MUDAL/Automated-Irrigation-System/Images/MQTT dashboard.jpg

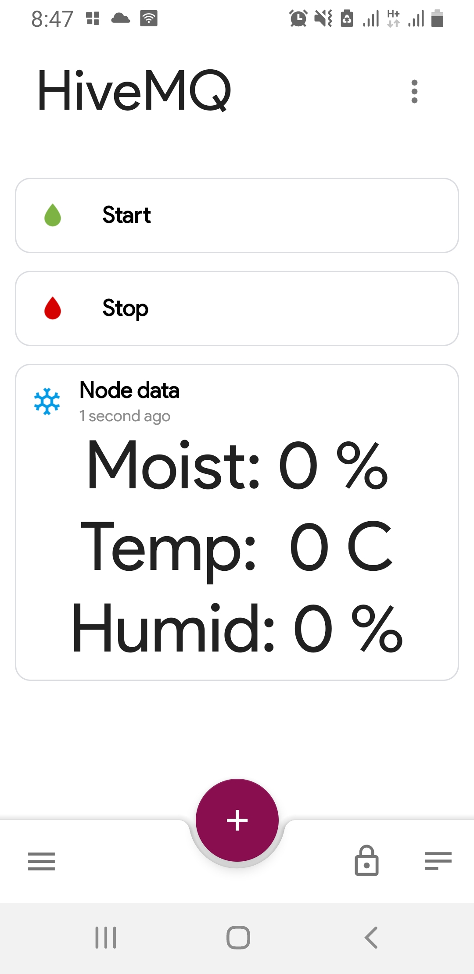
Images/MQTT dashboard.jpg
