MUDAL/Automated-Irrigation-System/Tests/README.md

# Tests

## ``Weather forecast experiment``  

## Credits  
1. https://randomnerdtutorials.com/esp32-http-get-open-weather-map-thingspeak-arduino/  

## HTTP request to get forecast from OpenWeatherMap.org  

Format: https://api.openweathermap.org/data/2.5/weather?q={city},{country_code}&APPID={api_key}  

After opening an account, an API key will be obtained.
To obtain the weather data for Ibadan (a city in Nigeria) with the API key, the following request is made:  

https://api.openweathermap.org/data/2.5/weather?q=Ibadan,NG&APPID={api_key}  
where ``api_key`` is the API key (use yours).    

## ``Other tests``  
1. RTC test  
2. LCD test  
3. Keypad test
