MUDAL/Automated-Irrigation-System/Schematic/Master/Auto_Irrig_Master_PDF.pdf

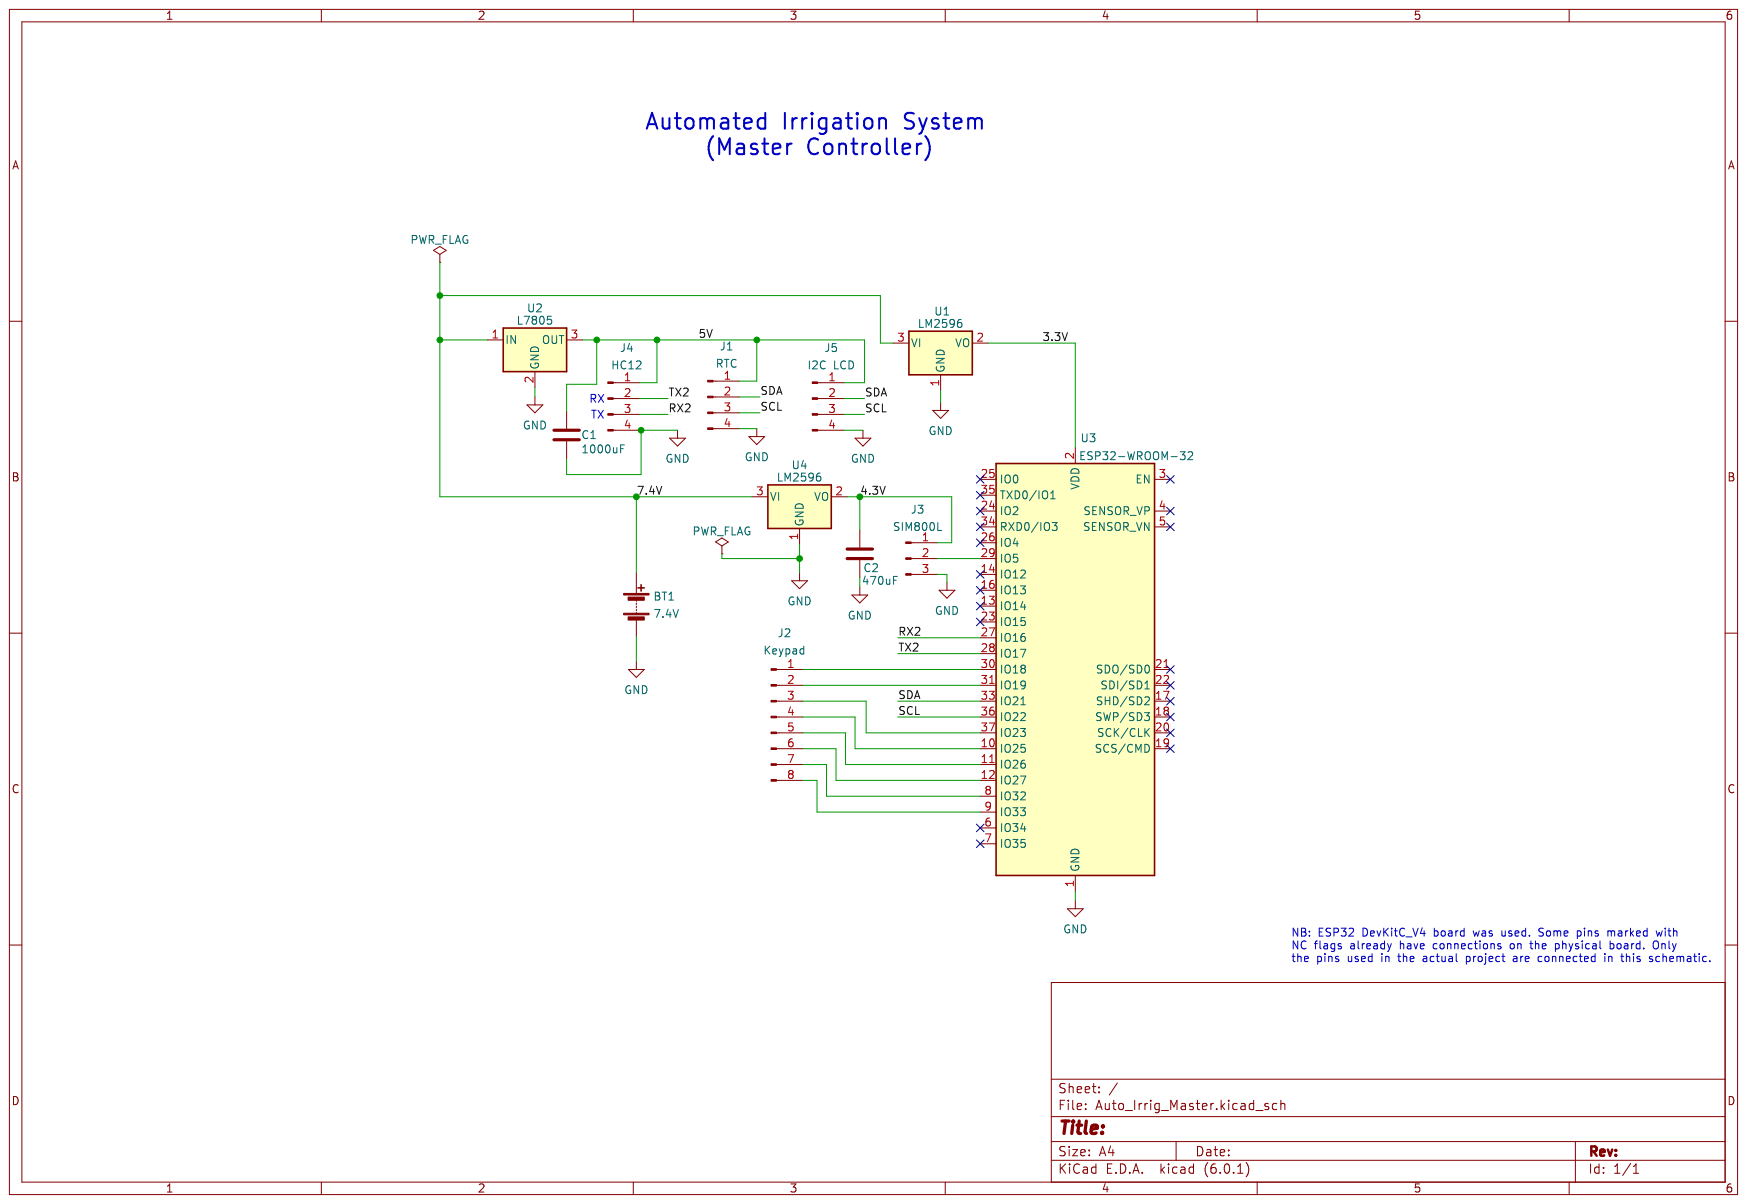
[picture p2: page 1]
