MUDAL/Automated-Irrigation-System/Schematic/Node/Auto_Irrig_Node_PDF.pdf

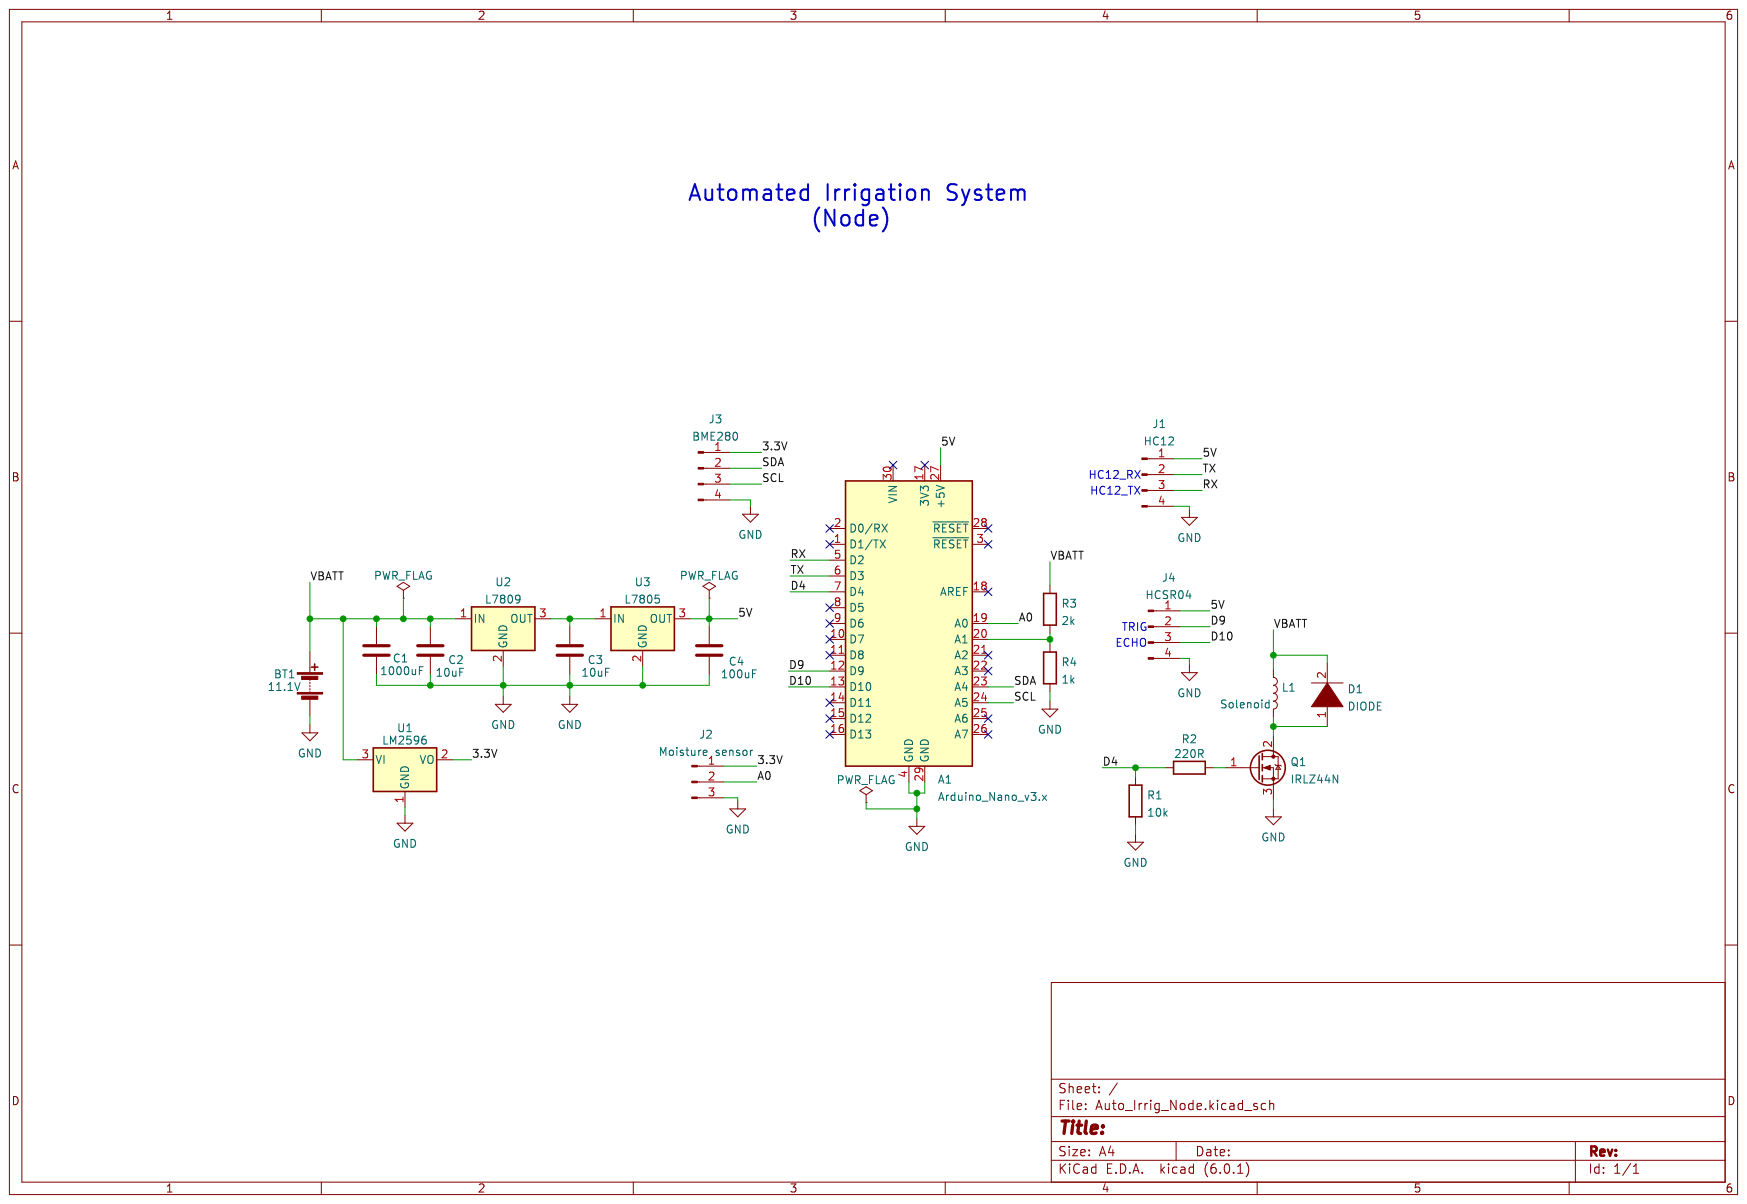
[picture p3: page 1]
