MUDAL/Automated-Irrigation-System/Schematic/Master/Auto_Irrig_Master/Auto_Irrig_Master.kicad_sch

## KiCad design Schematic/Master/Auto_Irrig_Master/Auto_Irrig_Master.kicad_sch (2023-03-10)

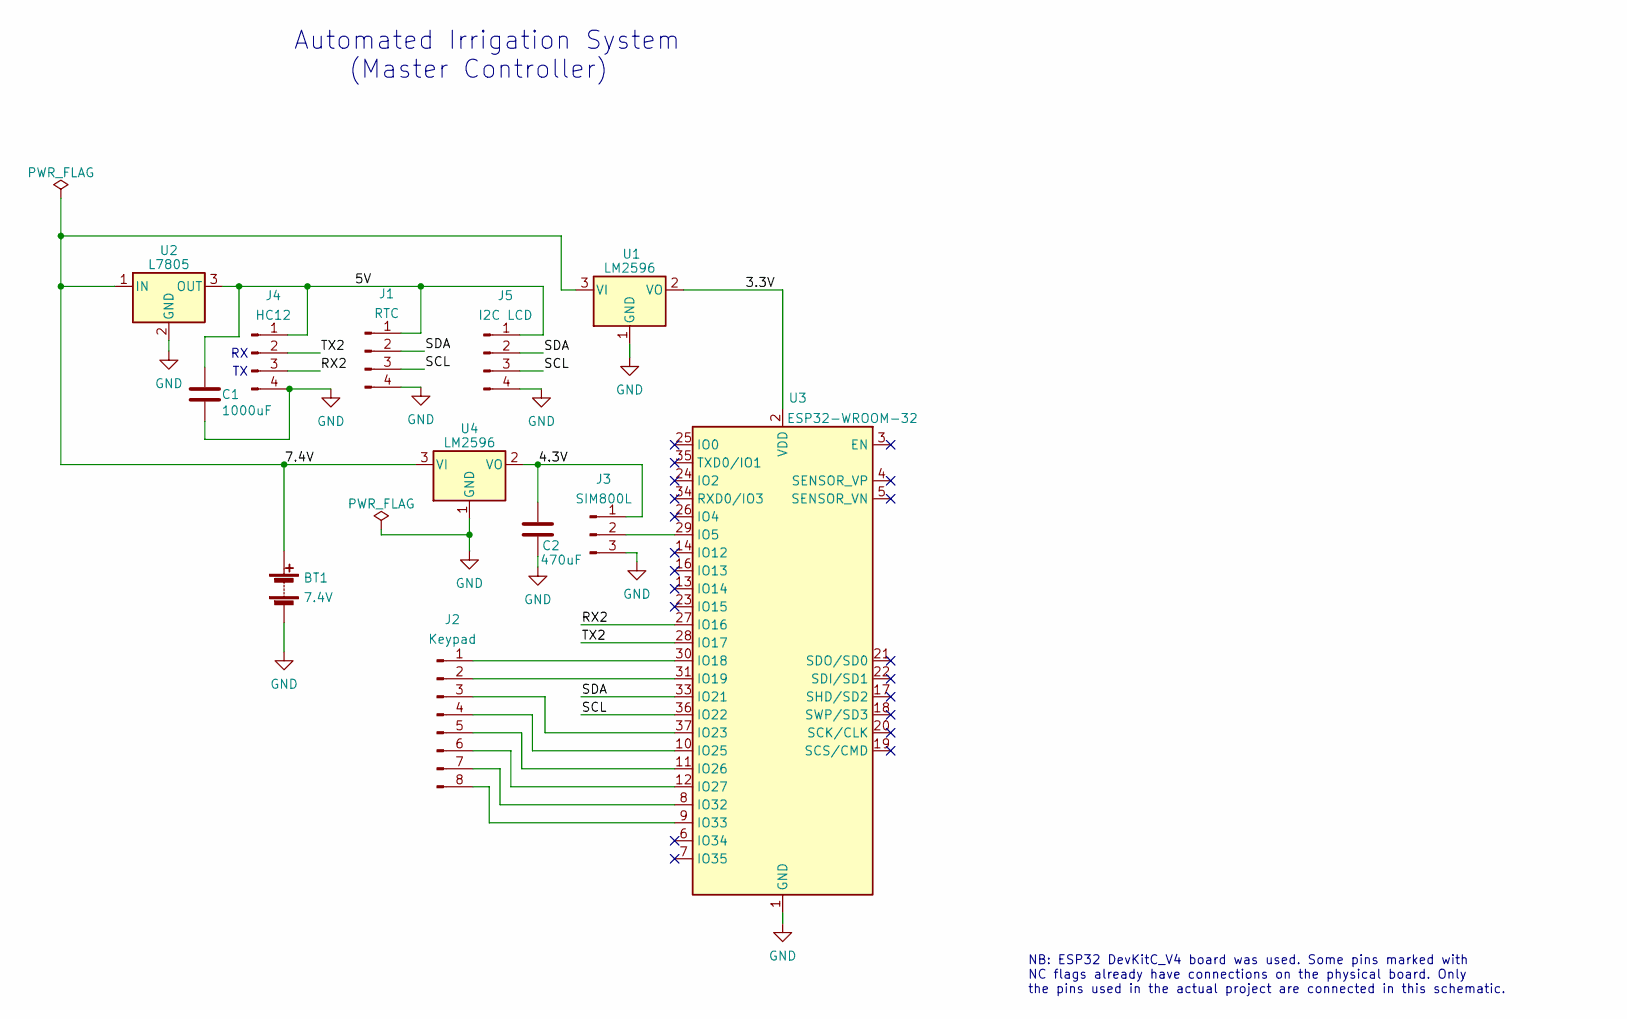
[picture p4: schematic Auto_Irrig_Master.kicad_sch]

Parts:
BT1: 7.4V
C1: 1000uF
C2: 470uF
J1: RTC
J2: Keypad
J3: SIM800L
J4: HC12
J5: I2C LCD
U1, U4: LM2596; SOT-223-3_TabPin2
U2: L7805
U3: ESP32-WROOM-32

Connections:
3.3V: U1.2 (VO), U3.2 (VDD)
4.3V: C2.1, J3.1, U4.2 (VO)
5V: C1.1, J1.1, J4.1, J5.1, U2.3 (OUT)
7.4V: BT1.1 (+), U1.3 (VI), U2.1 (IN), U4.3 (VI)
GND: BT1.2 (-), C1.2, C2.2, J1.4, J3.3, J4.4, J5.4, U1.1 (GND), U2.2 (GND), U3.1 (GND), U3.15 (GND), U3.38 (GND), U3.39 (GND), U4.1 (GND)
unnamed: J2.1, U3.30 (IO18)
unnamed: J2.2, U3.31 (IO19)
unnamed: J2.3, U3.37 (IO23)
unnamed: J2.4, U3.10 (IO25)
unnamed: J2.5, U3.11 (IO26)
unnamed: J2.6, U3.12 (IO27)
unnamed: J2.7, U3.8 (IO32)
unnamed: J2.8, U3.9 (IO33)
unnamed: J3.2, U3.29 (IO5)
RX2: J4.3, U3.27 (IO16)
SCL: J1.3, J5.3, U3.36 (IO22)
SDA: J1.2, J5.2, U3.33 (IO21)
TX2: J4.2, U3.28 (IO17)

Notes on the sheet:
Automated Irrigation System (Master Controller)
NB: ESP32 DevKitC_V4 board was used. Some pins marked with NC flags already have connections on the physical board. Only the pins used in the actual project are connected in this schematic.
