MUDAL/Automated-Irrigation-System/Schematic/Node/Auto_Irrig_Node/Auto_Irrig_Node.kicad_sch

## KiCad design Schematic/Node/Auto_Irrig_Node/Auto_Irrig_Node.kicad_sch (2023-03-10)

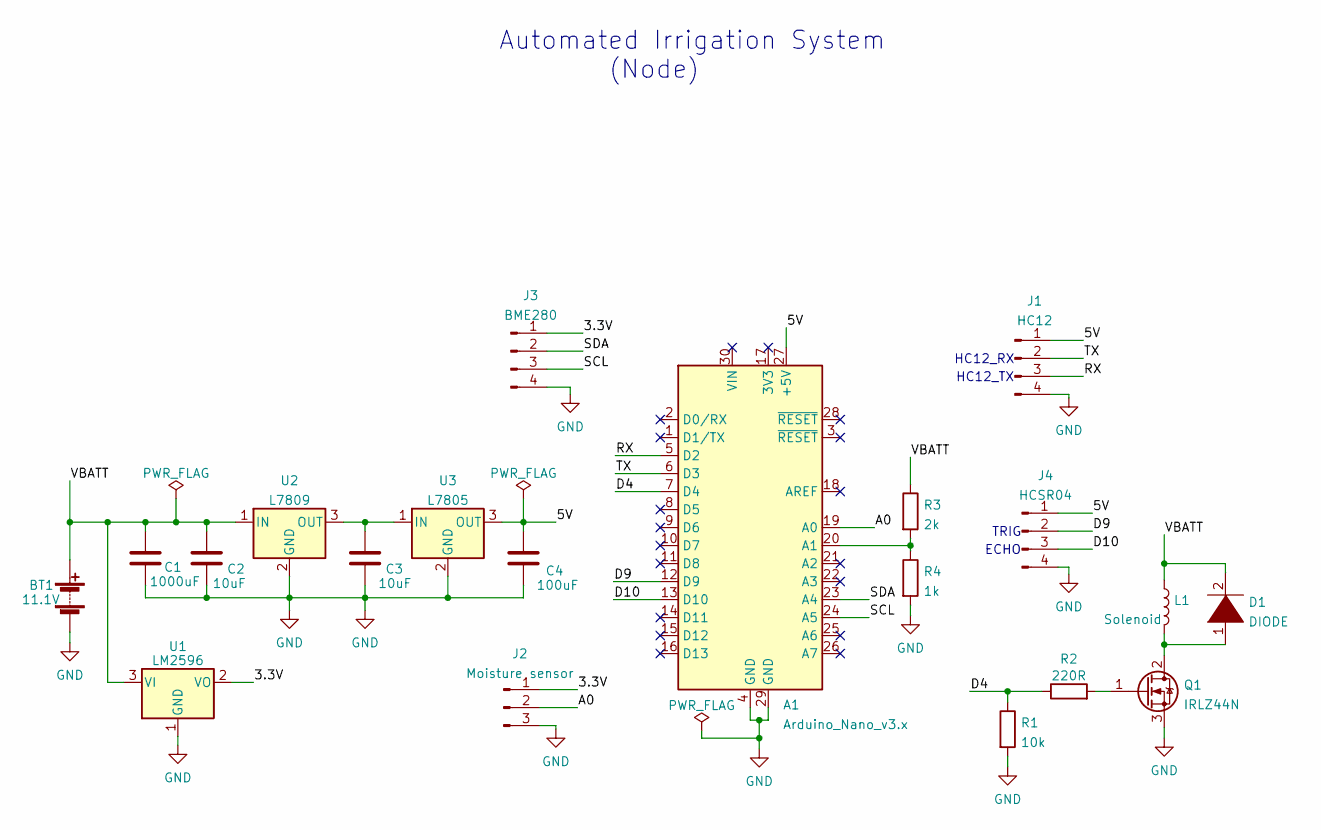
[picture p5: schematic Auto_Irrig_Node.kicad_sch]

Parts:
A1: Arduino_Nano_v3.x; Arduino_Nano
BT1: 11.1V
C1: 1000uF
C2, C3: 10uF
C4: 100uF
D1: DIODE
J1: HC12
J2: Moisture sensor
J3: BME280
J4: HCSR04
L1: Solenoid
Q1: IRLZ44N; TO-220-3_Vertical
R1: 10k
R2: 220R
R3: 2k
R4: 1k
U1: LM2596
U2: L7809
U3: L7805

Connections:
3.3V: J2.1, J3.1, U1.2 (VO)
5V: A1.27 (+5V), C4.1, J1.1, J4.1, U3.3 (OUT)
A0: A1.19 (A0), J2.2
D4: A1.7 (D4), R1.1, R2.1
D9: A1.12 (D9), J4.2
D10: A1.13 (D10), J4.3
GND: A1.4 (GND), A1.29 (GND), BT1.2 (-), C1.2, C2.2, C3.2, C4.2, J1.4, J2.3, J3.4, J4.4, Q1.3 (S), R1.2, R4.2, U1.1 (GND), U2.2 (GND), U3.2 (GND)
unnamed: A1.20 (A1), R3.2, R4.1
unnamed: C3.1, U2.3 (OUT), U3.1 (IN)
unnamed: D1.1 (K), L1.2, Q1.2 (D)
unnamed: Q1.1 (G), R2.2
RX: A1.5 (D2), J1.3
SCL: A1.24 (A5), J3.3
SDA: A1.23 (A4), J3.2
TX: A1.6 (D3), J1.2
VBATT: BT1.1 (+), C1.1, C2.1, D1.2 (A), L1.1, R3.1, U1.3 (VI), U2.1 (IN)

Notes on the sheet:
HC12_TX
TRIG
HC12_RX
Automated Irrigation System (Node)
ECHO
